JacksonHarvey1/FSAE2025/PIScreenshots/20260428_06h55m11s_grim.png

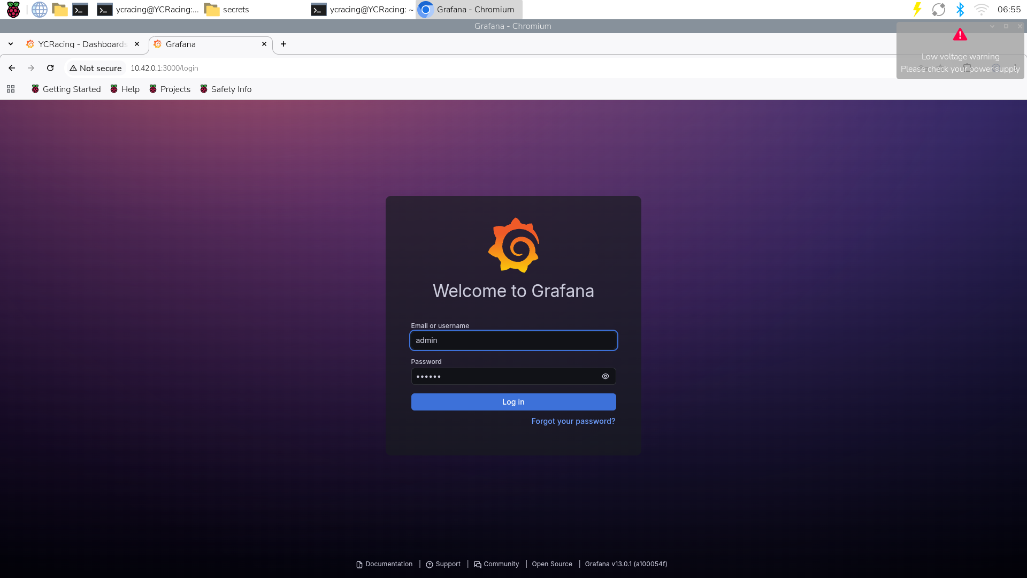
PIScreenshots/20260428_06h55m11s_grim.png
