JacksonHarvey1/FSAE2025/PIScreenshots/20260428_01h30m33s_grim.png

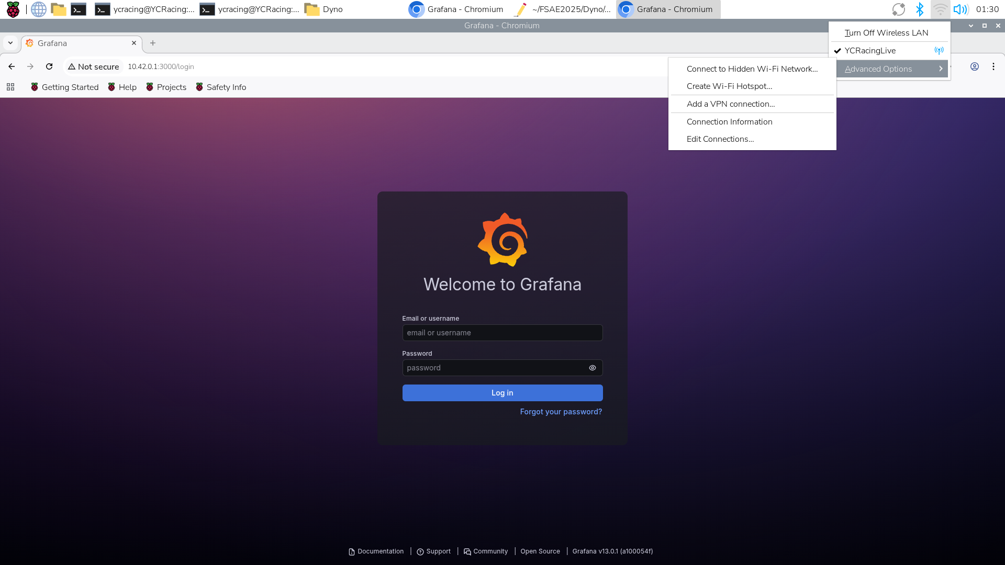
PIScreenshots/20260428_01h30m33s_grim.png
