JacksonHarvey1/FSAE2025/README.md

# YCP Formula SAE 2025 Telemetry System

Real-time data acquisition for the York College Formula SAE program. The car-side stack reads Bosch MS4.3 (PE3 8400) CAN frames, calculates gear, samples IMU/steering/fuel inputs, transmits the active LoRa packet stream over 915 MHz, mirrors the stream to a Raspberry Pi base station, and logs local SD plus InfluxDB/Grafana data for analysis.

---

## Quick Start (Car-Focused)
1. **Hardware** - Two Adafruit Feather RP2040 RFM boards (PID 5714), one on-car with MCP2515 CAN transceiver, LSM6DSOX IMU, MCP4725 DAC, and SPI SD breakout; the second Feather sits at the base station as the LoRa receiver. Terminate the car CAN bus at 500 kbps.
2. **Libraries** - Install the Earle Philhower `arduino-pico` cores plus **RadioHead (RH_RF95)**, **SdFat**, **Adafruit LSM6DS**, **Adafruit Unified Sensor**, and **Adafruit BusIO**. Local copies live under `libraries/`.
3. **On-car telemetry firmware** - Open `Car/CarCanLoRaTx/CarCanLoRaTx.ino`, confirm pin assignments/table below, set LoRa region (default 915 MHz @ 17 dBm), build, and flash. Keep the board still for the gyro bias routine at boot.
4. **Standalone dash firmware** - `Car/CarDash/CarDash.ino` is the dash-only CAN reader for gear DAC + warning LEDs when LoRa/SD/IMU logging is not needed.
5. **Base-station firmware** - Flash `Car/CarLoRaRxToPi/CarLoRaRxToPi.ino` onto the second Feather. Connect via USB to the Pi (or a laptop) at 115200 baud to watch NDJSON output.
6. **Pi ingest** - On the Raspberry Pi in the pit/dyno cart, run `Dyno/dyno_ingest_influx.py` for a lightweight logger or bring up the full Docker stack in `Dyno/stack/` (InfluxDB 2 + Grafana). Dash-only development can use `Dyno/Dyno_Final.py`.
7. **Verify** - Use the serial console: `[STATUS]` and `[GCALC]` lines from the TX/dash sketches, JSON from the RX sketch, and `test_json_serial.py` or `Dyno/dyno_simple.py` to sanity-check data before a run.

---

## Repository Map
```
FSAE2025/
|-- Car/
|   |-- CarCanLoRaTx/           # On-car CAN->LoRa transmitter (Feather RP2040 RFM)
|   |-- CarDash/                # Standalone dash: CAN gear DAC + warning LEDs
|   `-- CarLoRaRxToPi/          # Base-station LoRa receiver -> USB serial JSON
|-- Dyno/                       # Pi ingest scripts, Dash UI, Docker stack, docs
|   |-- DynoRP2040_MCP2515Wing/ # Optional dyno-only Feather CAN sketch
|   `-- stack/                  # compose.yaml + helper scripts (InfluxDB/Grafana)
|-- Testing/                    # Stand-alone CAN/LoRa/SD/IMU sketches + Python tools
|-- Data/                       # Logged CSVs, Excel analysis, post-processing scripts
|-- Reference Documents/        # Bosch DBC, datasheets, wiring diagrams
|-- libraries/                  # Vendored Arduino deps (Adafruit_* and RadioHead)
|-- Archive/                    # 2024 code + experiments (read-only history)
`-- README.md                   # You are here
```

---

## System Architecture
```
+----------------------------- CAR ----------------------------------+
| Bosch PE3 8400 ECU (500 kbps CAN)                                 |
|    |                                                              |
|  MCP2515 + Feather RP2040 RFM   LSM6DSOX   MCP4725   SD (SPI)      |
|    |             |                |         |         |            |
|    +-- CarCanLoRaTx.ino -- LoRa 915 MHz -----------------------+   |
+-------------------------------------------------------------------+
                             |
                             v
+------------------------- Base Station -----------------------------+
| Feather RP2040 RFM (CarLoRaRxToPi.ino) -> USB serial NDJSON        |
| Raspberry Pi                                                       |
|  - dyno_ingest_influx.py -> InfluxDB 2.x                           |
|  - Dyno/stack (docker compose) -> InfluxDB + Grafana               |
|  - Dyno_Final.py / dyno_simple.py (Dash/matplotlib live view)      |
+-------------------------------------------------------------------+
                             |
               Wi-Fi hotspot / Ethernet for driver, dyno, cloud
```

---

## Car Platform

### Hardware Stack
| Subsystem | Part | Notes |
|---|---|---|
| MCU + LoRa | Adafruit Feather RP2040 RFM (915 MHz RFM95) | Shared SPI bus for CAN/LoRa/SD |
| CAN | MCP2515 + TJA1050 (or similar) | 16 MHz crystal, configured for 500 kbps |
| IMU | Adafruit LSM6DSOX | I2C @ 0x6A, sampled at 100 Hz |
| Gear DAC | MCP4725 | I2C @ 0x60 (A0=GND). Output drives PE3 Analog #5 (0-5 V). |
| Storage | SPI microSD breakout | Uses SdFat in shared SPI mode; active TX logs at 50 Hz |
| Sensors (Dyno) | Optional Feather RP2040 CAN + LSM6DSOX | See `Dyno/DynoRP2040_MCP2515Wing` |

### Feather RP2040 RFM Pin Map (Car TX)
| Function | GPIO | Notes |
|---|---|---|
| SPI MISO | 8 | Shared CAN / LoRa / SD |
| SPI MOSI | 15 | Shared |
| SPI SCK | 14 | Shared |
| MCP2515 CS | 5 | Adafruit CAN FeatherWing default CS |
| RFM95 CS / INT / RST | 16 / 21 / 17 | RFM95 is on-board; RST toggled at boot |
| SD CS | 25 | Initialize SD *before* the radio |
| I2C SDA / SCL | 2 / 3 | IMU (0x6A) + DAC (0x60) |
| Steering angle ADC | A0 (GP26) | 0-5 V pot -> voltage divider -> 0-3.3 V |
| Fuel level sensor | A1 (GP27) | Telemetry TX uses 10 kOhm pull-up + PANW 103395-395 NTC; dash sketch uses voltage threshold only |
| Neutral switch input | 12 | `INPUT_PULLUP`; LOW = neutral |
| Engine warning LED | 11 | SK6812 NeoPixel; red if CLT > 200 F |
| Oil pressure warning LED | 7 | SK6812 NeoPixel in `CarCanLoRaTx`; red if oil < 30 psi |
| Shift indicator LED | 9 | SK6812 NeoPixel; blue if RPM >= 13,000 |
| Low fuel warning LED | 10 | SK6812 NeoPixel; amber after A1 stays below threshold for 15 s |
| Neutral light LED | 6 | SK6812 NeoPixel; green when neutral switch is LOW or calculated gear is neutral |
| On-board LED | LED_BUILTIN | Heartbeat / status blink |

---

### `Car/CarCanLoRaTx/CarCanLoRaTx.ino`
* **CAN ingest** - Custom MCP2515 driver configures CNF1/2/3 for 500 kbps @ 16 MHz. Frames `0x770` / `0x771` / `0x772` / `0x790` are decoded to engineering units — see [Transmitted Data](#transmitted-data) below for the full field list.
* **IMU pipeline** - LSM6DSOX is initialized at 104 Hz, gyro bias is averaged for one second on boot, and 100 Hz samples are converted to g and deg/s for local SD logging.
* **Gear detection + DAC** - `GEAR_BANDS` holds RPM/kph ratio bands with hysteresis and sample confirmation (4 consecutive matches) to avoid flapping. `MCP4725` outputs the midpoint voltages: Neutral 0.305 V, 1st 1.00 V, 2nd 1.70 V, 3rd 2.50 V, 4th 3.305 V, 5th 4.095 V. The DAC is forced to Neutral at boot so PE3 always sees a safe voltage.
* **LoRa link** - RFM95 sends binary packets over 915 MHz @ 17 dBm (all little-endian). The lower transmit power avoids 3.3 V rail droop during radio bursts.

  | Type | Size | Header | Payload |
  |------|------|--------|---------|
  | `0x01` CAN frame | 24 B | `[0xA5][0x01][flags][dlc]` | `[id:4][ts_ms:4][data:8][seq:4]` |
  | `0x02` IMU | 22 B | `[0xA5][0x02][seq:4][ts_ms:4]` | `[ax/ay/az x 0.001 g : 3 x int16][gx/gy/gz x 0.1 deg/s : 3 x int16]`; supported by the RX/test harness, not currently emitted by `CarCanLoRaTx` |
  | `0x03` Analog | 12 B | `[0xA5][0x03][seq:4][ts_ms:4]` | `[steer x 0.1 deg : int16]` |

* **SD logging** - `LOG_####.CSV` files capture the following columns at 50 Hz using an 8 KB RAM buffer that flushes every second. SdFat runs in `SHARED_SPI` mode so the SD must be initialized before the radio.
  `ts_s, rpm, gear, ax_g, ay_g, az_g, gx_dps, gy_dps, gz_dps, steer_deg`
* **Serial diagnostics** - The sketch prints `[STATUS]`, `[GCALC]`, decoded CAN values, and IMU details. If MCP2515 reports `EFLG != 0`, the flag byte is shown for quick wiring debug.
* **Build settings** - Board: `Adafruit Feather RP2040` (Earle Philhower core). Use 125 MHz CPU, 16 MB flash (2 MB sketch). Required libraries live in `libraries/` if you prefer `arduino-cli --libraries`. LoRa frequency/power are at the top of the file.

**Modifying CAN channels:** Add decode logic inside `updateTxSnapshot` and `printDecoded`, then extend the JSON emitters on the RX side (see below) or the SD logger header to capture new fields. Use `Reference Documents/70000003 PE3 Bosch MS4.3 CAN Bus v01.dbc` to map IDs.

---

### `Car/CarDash/CarDash.ino`
* **Purpose** - Lightweight dash firmware for the Feather RP2040 + CAN FeatherWing when the car only needs local gear DAC and warning indicators. It does not initialize LoRa, SD, or the IMU.
* **CAN inputs** - Reads Bosch `0x770` and `0x790` at 500 kbps for RPM, vehicle speed, and coolant temperature. Stale RPM/speed values are zeroed after a 500 ms CAN timeout.
* **Outputs** - Drives the MCP4725 gear voltage table used by the PE3 Analog #5 input and the SK6812 warning LEDs. The neutral light uses a dedicated switch on GPIO 12 (`INPUT_PULLUP`, LOW = neutral).
* **Dash thresholds** - Engine warning at CLT > 200 F, shift light at RPM >= 13,000, low fuel after A1 stays below 1.2 V for 15 s. Serial status prints every 5 s.

---

### `Car/CarLoRaRxToPi/CarLoRaRxToPi.ino`
* **Purpose** - Listens for the binary LoRa frames above, reconstructs the Bosch snapshot, and streams newline-delimited JSON (NDJSON) at 10 Hz over USB (115200 baud). IMU packets are supported and emitted immediately with `"t":"imu"` if a transmitter sends packet `0x02`.
* **JSON fields (Bosch line)** - `pkt,rpm,veh_kph,tps_pct,map_kpa,map_ext_kpa,batt_v,coolant_f,air_f,oil_temp_f,ign_deg,lambda1,lambda2,fuel_psi,oil_psi,inj_ms,gear,rssi`.
* **IMU JSON** - `{"t":"imu","pkt":<seq>,"ax_g":...,"gx_dps":...,"rssi":...}` for packet `0x02`.
* **Heartbeat** - Lines starting with `#` provide uptime, packet counts, and last RSSI for shell scripts to monitor.
* **Integration points** - `Dyno/dyno_ingest_influx.py`, `Dyno/dyno_simple.py`, and `Testing/test_json_serial.py` all expect this NDJSON stream.

---

## Transmitted Data

Active car LoRa traffic uses `0xA5` packet types. `CarCanLoRaTx` currently emits raw CAN frames (`0x01`) and steering analog (`0x03`); `CarLoRaRxToPi` also supports IMU packet `0x02` for test transmitters or future TX firmware.

### Packet 0x01 — Bosch MS4.3 CAN Frames

Raw CAN frames from the four decoded IDs. The receiver reconstructs the snapshot from the row-muxed payloads.

| CAN ID | Row / Condition | Field | Source formula | Units |
|---|---|---|---|---|
| 0x770 | any | **RPM** | `u16(d[1],d[2]) × 0.25` | rpm |
| 0x770 | any | **Vehicle speed** | `u16(d[3],d[4]) × 0.00781` | km/h |
| 0x770 | any | **Throttle position (TPS)** | `d[5] × 0.391` | % |
| 0x770 | any | **Ignition advance** | `(int8)d[6] × 1.365` | °BTDC |
| 0x770 | row 3 | **Coolant temp (CLT)** | `d[7] − 40` | °C |
| 0x770 | row 4 | **Oil temp 1 (ECU)** | `d[7] − 39` | °C |
| 0x770 | row 6 | **Intake air temp (IAT)** | `d[7] − 40` | °C |
| 0x770 | row 9 | **Gear (ECU)** | `d[7]` | 0–5 |
| 0x771 | row 0 | **MAP** | `u16(d[5],d[6]) × 0.01` | kPa |
| 0x771 | row 1 | **Battery voltage** | `d[7] × 0.111` | V |
| 0x771 | row 3 | **Fuel pressure** | `d[5] × 0.0515 × 14.504` | psi |
| 0x771 | row 3 | **Oil pressure** | `d[7] × 0.0513 × 14.504` | psi |
| 0x772 | row 0 | **Lambda 1** | `u16(d[2],d[3]) × 0.000244` | λ |
| 0x772 | row 0 | **Lambda 2** | `u16(d[4],d[5]) × 0.000244` | λ |
| 0x772 | row 3 | **Injector pulse width** | `d[2] × 0.8192` | ms |
| 0x790 | — | **RPM (hi-res)** | `u16(d[0],d[1])` | rpm |
| 0x790 | — | **Ignition (hi-res)** | `u16(d[4],d[5]) × 0.1` | °BTDC |
| 0x790 | — | **MAP (ext)** | `u16(d[6],d[7]) × 0.01 × 6.895` | kPa |

### Packet 0x02 — IMU (LSM6DSOX, 100 Hz)

| Field | Scaling | Units |
|---|---|---|
| **Accel X (ax)** | int16 × 0.001 | g |
| **Accel Y (ay)** | int16 × 0.001 | g |
| **Accel Z (az)** | int16 × 0.001 | g |
| **Gyro X (gx)** | int16 × 0.1 | °/s |
| **Gyro Y (gy)** | int16 × 0.1 | °/s |
| **Gyro Z (gz)** | int16 × 0.1 | °/s |

Gyro bias is averaged over 1 second at boot and subtracted from every local SD sample. Packet `0x02` is decoded by the receiver but is not currently sent by the active `CarCanLoRaTx` sketch.

### Packet 0x03 — Analog Sensors (2 Hz)

| Field | Pin | Scaling | Units |
|---|-----|---|---|
| **Steering angle** | A0 / GP26 | int16 × 0.1 | ° (neg = left) |

### Calculated / Derived Fields (on-car, also logged to SD)

| Field | Derivation |
|---|---|
| **Gear (calculated)** | RPM ÷ km/h ratio matched against `GEAR_BANDS[5]` with 4-sample hysteresis |
| **Fuel level** | A1 / GP27 voltage threshold. `CarCanLoRaTx`: `FUEL_LOW_THRESH_V = 1.52 V`; `CarDash`: `FUEL_LOW_THRESH_V = 1.2 V`. Both require 15 s continuously below threshold. |
| **Gear DAC output** | `MCP4725` drives PE3 Analog #5: N=0.305 V, 1st=1.00 V, 2nd=1.70 V, 3rd=2.50 V, 4th=3.305 V, 5th=4.095 V |

### InfluxDB Schema

The ingest script (`Dyno/dyno_ingest_influx.py`) writes all fields to a single measurement.

| Parameter | Value |
|---|---|
| **Measurement** | `telemetry` |
| **Tag: system** | `dyno` |
| **Tag: node** | `rp2040` |
| **Organisation** | `yorkracing` |
| **Bucket** | `telemetry` |

| InfluxDB Field | Source | Units |
|---|---|---|
| `rpm` | 0x770 / 0x790 | rpm |
| `veh_kph` | 0x770 | km/h |
| `tps_pct` | 0x770 | % |
| `ign_deg` | 0x770 / 0x790 | °BTDC |
| `map_kpa` | 0x771 row 0 | kPa |
| `map_ext_kpa` | 0x790 | kPa |
| `lambda1` | 0x772 row 0 | λ |
| `lambda2` | 0x772 row 0 | λ |
| `batt_v` | 0x771 row 1 | V |
| `coolant_f` | 0x770 row 3 | °F |
| `oil_temp_f` | 0x770 row 4 | °F |
| `air_f` | 0x770 row 6 | °F |
| `gear` | 0x770 row 9 | 0–5 |
| `fuel_psi` | 0x771 row 3 | psi |
| `oil_psi` | 0x771 row 3 | psi |
| `inj_ms` | 0x772 row 3 | ms |
| `ax_g` | IMU packet 0x02 | g |
| `ay_g` | IMU packet 0x02 | g |
| `az_g` | IMU packet 0x02 | g |
| `gx_dps` | IMU packet 0x02 | °/s |
| `gy_dps` | IMU packet 0x02 | °/s |
| `gz_dps` | IMU packet 0x02 | °/s |
| `rssi` | LoRa link quality | dBm |

Example Flux query for Grafana:
```flux
from(bucket: "telemetry")
  |> range(start: -5m)
  |> filter(fn: (r) => r._measurement == "telemetry")
  |> filter(fn: (r) => r._field == "rpm" or r._field == "tps_pct")
```

---

### Warning Indicators (on-car LEDs only, not transmitted)

| LED | Trigger |
|-----|---|
| Engine warning (red) | CLT > 200 °F |
| Oil pressure warning (red) | `CarCanLoRaTx` only: oil < 30 psi |
| Low fuel (amber) | A1 below threshold for 15 s |
| Shift indicator (blue) | RPM >= 13,000 |
| Neutral light (green) | Neutral switch LOW in `CarDash`; calculated gear == 0 in `CarCanLoRaTx` |

---

## Raspberry Pi + Cloud Stack (`Dyno/`)
* **Live ingest script** - `Dyno/dyno_ingest_influx.py` auto-detects the Feather serial port, filters non-JSON lines, de-dupes packets, and writes measurements to InfluxDB 2.x using the `influxdb-client` Python SDK. Environment overrides: `TELEM_PORT`, `TELEM_BAUD`, `INFLUX_URL`, `INFLUX_ORG`, `INFLUX_BUCKET`, `INFLUX_TOKEN` or `INFLUX_TOKEN_FILE`.
* **Full Pi setup guide** - `Dyno/PI_SETUP.md` covers everything end-to-end: WiFi hotspot, Docker stack autostart, and ingest autostart on a fresh Pi. Start here for any new hardware.
* **Docker services** - `Dyno/stack/compose.yaml` launches InfluxDB 2 + Grafana with persistent volumes. Copy the example secrets in `Dyno/stack/secrets/`, edit passwords/tokens, then `docker compose up -d`. Helper scripts (`setup_grafana.sh`, `fix_influxdb.sh`, etc.) automate first-boot tasks.
* **Dash UI** - `Dyno/Dyno_Final.py` is a Plotly Dash app for laptops or the Pi. It auto-detects the serial port, streams packets, and exposes UI controls for key selection, time window, and theming. `Dyno/dyno_simple.py` is a lighter matplotlib live plot.
* **Services & Wi-Fi** - `Dyno/dyno-ingest.service` and `Dyno/start_ingest.sh` provide systemd units for auto-start, while `Dyno/WIFI_HOTSPOT_SETUP.md` documents the dedicated `YorkRacing` hotspot used at the track/dyno.

---

## Dyno Bench Node
`Dyno/DynoRP2040_MCP2515Wing/DynoRP2040_MCP2515Wing.ino` targets a Feather RP2040 plus the Adafruit CAN FeatherWing. It mirrors the Bosch decode logic but sends JSON directly over USB at 20 Hz (921600 baud) and can optionally include IMU data. Use this when the car is not available but you still need CAN data on the dyno.

`Dyno/DynoRP204CANHATIntegration/` holds an earlier variant that pairs the Feather with a Raspberry Pi CAN hat; keep it for reference or regression tests.

---

## Testing & Diagnostics (`Testing/`)
* **CAN + LoRa harness** - `Testing/TransmitterCANTest/` and `Testing/ReciverCANTest/` form a loopback pair documented in `Testing/CANTest_README.md`. `TransmitterCANTest` generates synthetic waveforms for `0x01` CAN frames, `0x02` IMU, and the older 14-byte `0x03` analog packet that includes steering plus oil temp 2; the active car TX now sends the 12-byte steering-only `0x03` packet.
* **Focused sketches** - `BoschDecodeTest`, `SDCardTest`, `AccelerometerAndGyro`, `SimpleCANTest`, `TransmitterTest`, etc., isolate each subsystem for bench validation.
* **Python utilities** - `simple_serial_test.py`, `test_json_serial.py`, and `pyserialAccelerometerLogging.py` consume NDJSON or raw serial streams for quick plots and logging on a laptop.
* **Recommended workflow** - Run the CAN/LoRa pair first, then `SDCardTest` with the actual SD breakout, finish with the full `CarCanLoRaTx` sketch on a bench harness before installing on the vehicle.

---

## Data & Post-Processing (`Data/`)
* `Data/2025 Car/Car Runs/` - CSV + Excel workbooks from recent runs (`10_18_runX_001.*`). Use them as templates for new SD logs.
* `Data/Dyno Runs/` - Protected directory for dyno pulls captured through the Pi stack.
* Utility scripts (`postproccess.py`, `check_map_columns.py`, `debug_columns.py`) normalize CSV columns and validate field names before import into Grafana or analysis notebooks.

---

## Reference Documents
Key resources for calibration, wiring, and CAN math:
* `Reference Documents/70000003 PE3 Bosch MS4.3 CAN Bus v01.dbc` - Official Bosch signal map used by both the transmitter and receiver sketches.
* Datasheets for every breakout (Feather RP2040 RFM, MCP4725, LSM6DSOX, MicroSD breakouts, CAN protocol notes) plus historical FSAE electrical documentation for 2023-2025 seasons.

---

## Libraries & Third-Party Assets
* `libraries/Adafruit_BusIO`, `Adafruit_CAN`, `Adafruit_MCP2515`, `RadioHead-master`, etc., mirror the versions tested with this repo. Point the Arduino IDE/CLI to this folder or install matching releases via the Library Manager.
* `RadioHead-master.zip` at the repo root is the original upstream archive; extract or remove after verifying the vendored copy.
* Python dependencies: `pyserial`, `influxdb-client`, `dash`, `dash-bootstrap-components`, `plotly`. Use a venv on the Pi/laptop to keep them isolated.

---

## Archive
`Archive/2024` and `Archive/2025` store past experiments (single-packet LoRa tests, dashboard prototypes, Raspberry Pi scripts, etc.). Treat them as read-only examples; all active firmware now lives under `Car/` and `Dyno/`.

---

## Extending the System
1. **Add a CAN channel** - Update the decode logic in both `CarCanLoRaTx` (for SD/gear calculations) and `CarLoRaRxToPi` (for JSON output). Reference the DBC for scaling, then update Grafana/Dash configs.
2. **Change LoRa behavior** - Adjust `LORA_FREQ_MHZ` and `LORA_TX_POWER_DBM` constants in both sketches. Keep the packet headers the same so existing ingest tools keep working.
3. **Tune gear detection** - Modify `GEAR_BANDS` and `GEAR_CONFIRM` after reviewing `[GCALC]` logs from real laps. The DAC table can also be tweaked if the PE3 calibration targets move.
4. **Stream to new backends** - Reuse `Dyno/dyno_ingest_influx.py` as a template (it already exposes JSON parsing utilities) if you need to forward data to MQTT, ROS, or cloud APIs.

With this README, new team members can follow the breadcrumb trail from hardware selection through firmware, ingestion, dashboards, and testing-especially on the car side where the CAN, IMU, SD, gear DAC, and LoRa stacks all converge. Happy tuning!
