JacksonHarvey1/FSAE2025/PIScreenshots/20260427_22h56m39s_grim.png

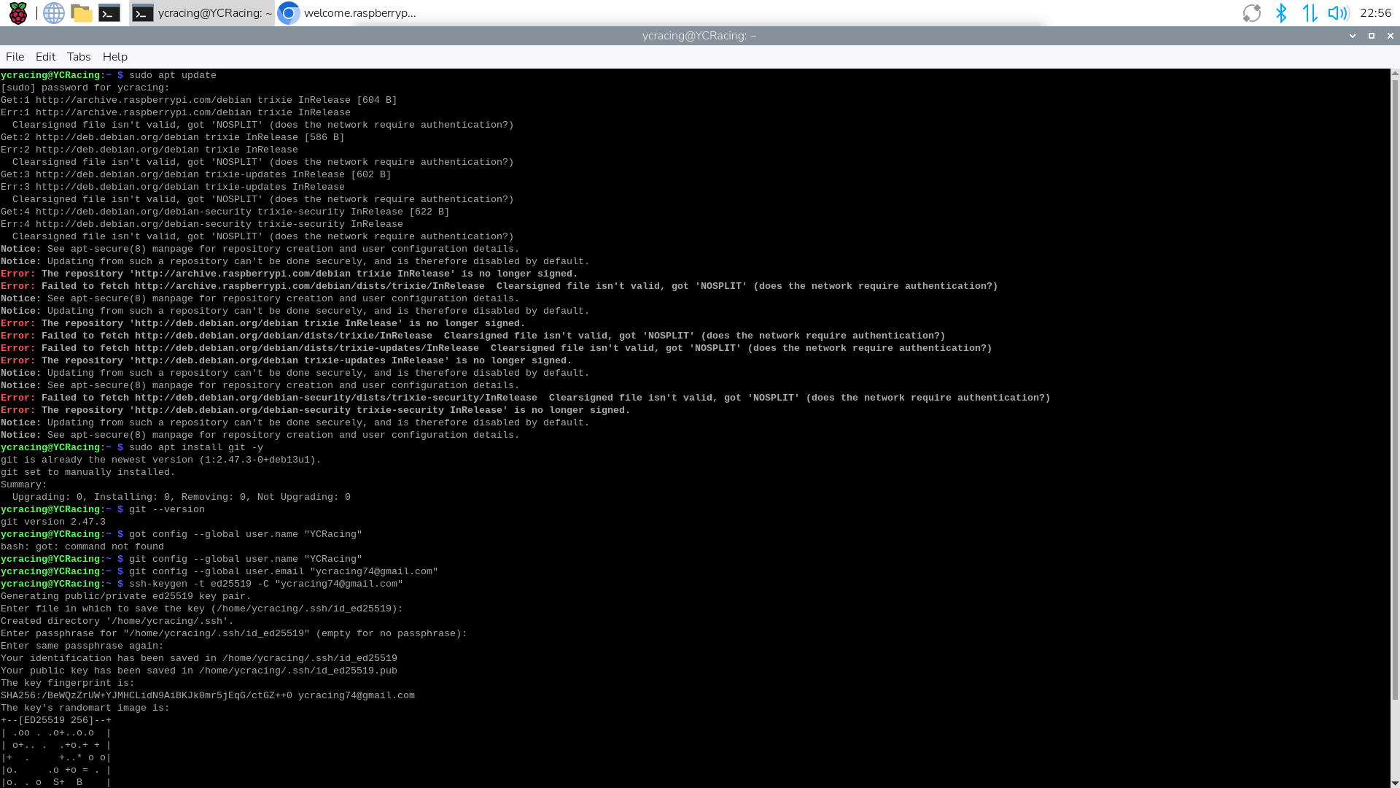
PIScreenshots/20260427_22h56m39s_grim.png
