JacksonHarvey1/FSAE2025/PIScreenshots/20260427_23h25m05s_grim.png

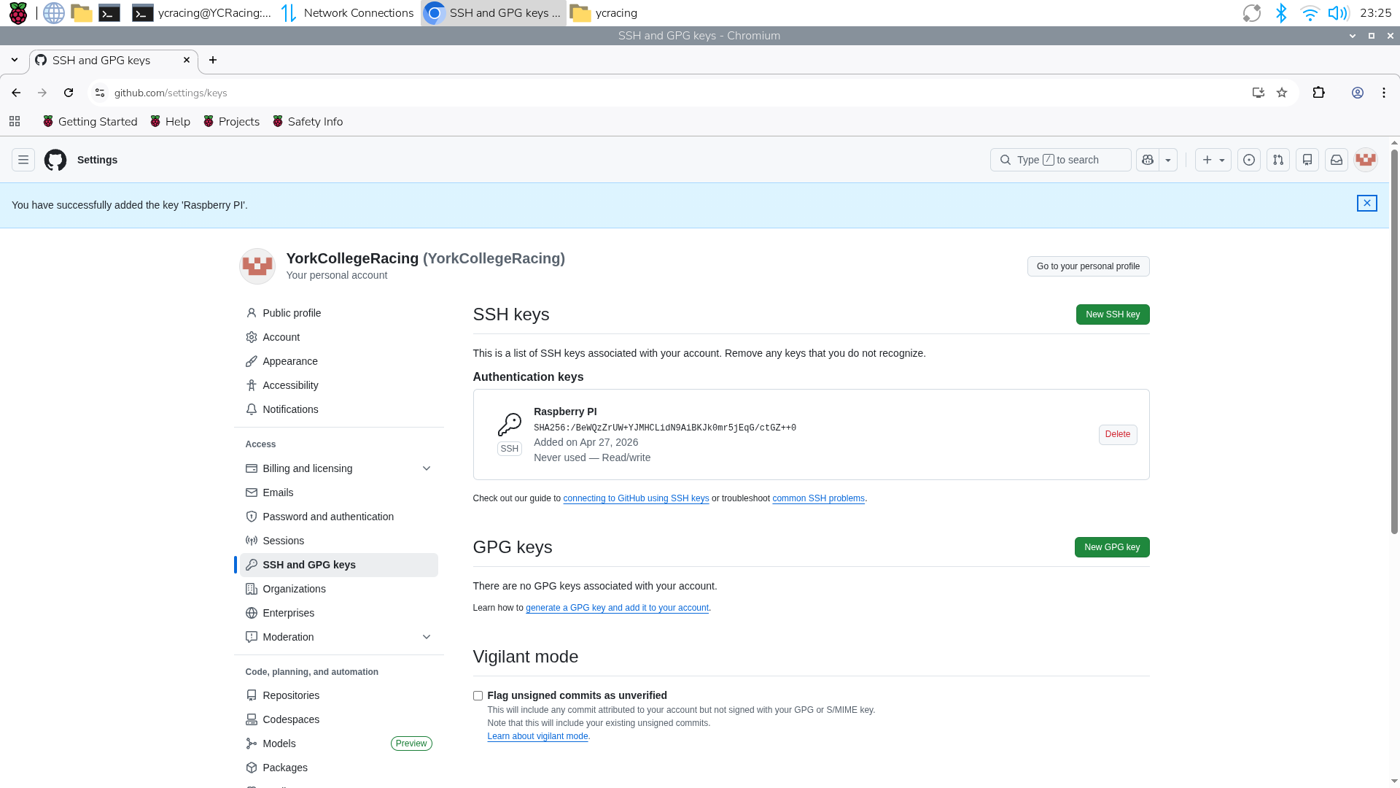
PIScreenshots/20260427_23h25m05s_grim.png
