JacksonHarvey1/FSAE2025/PIScreenshots/20260427_23h31m36s_grim.png

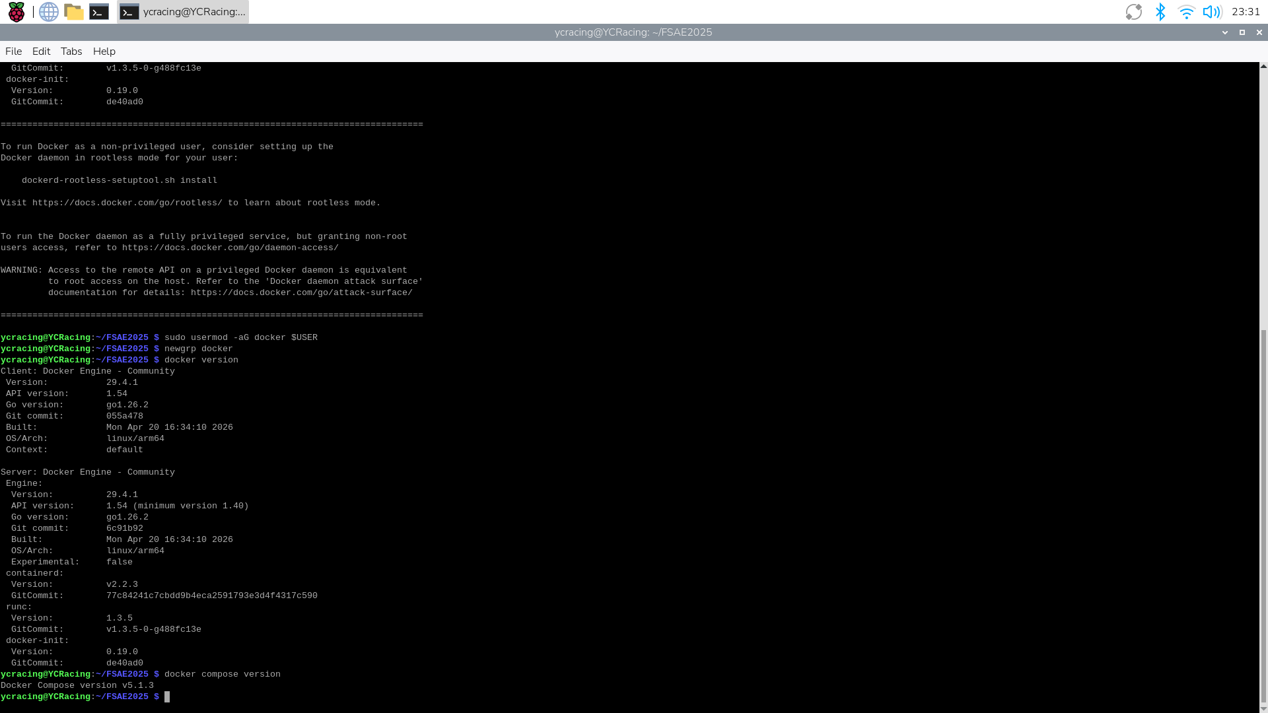
PIScreenshots/20260427_23h31m36s_grim.png
