JacksonHarvey1/FSAE2025/PIScreenshots/20260428_01h23m13s_grim.png

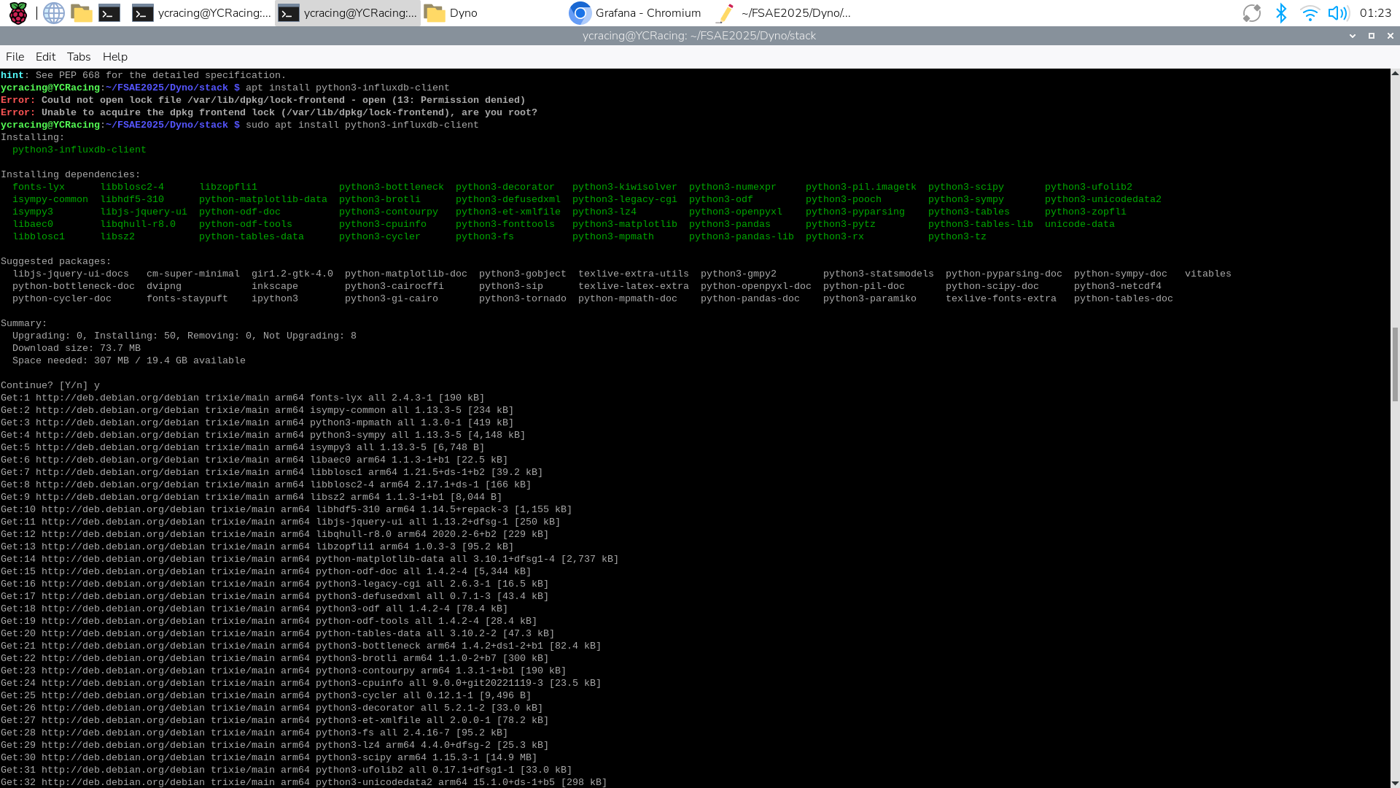
PIScreenshots/20260428_01h23m13s_grim.png
