JacksonHarvey1/FSAE2025/PIScreenshots/20260428_02h02m52s_grim.png

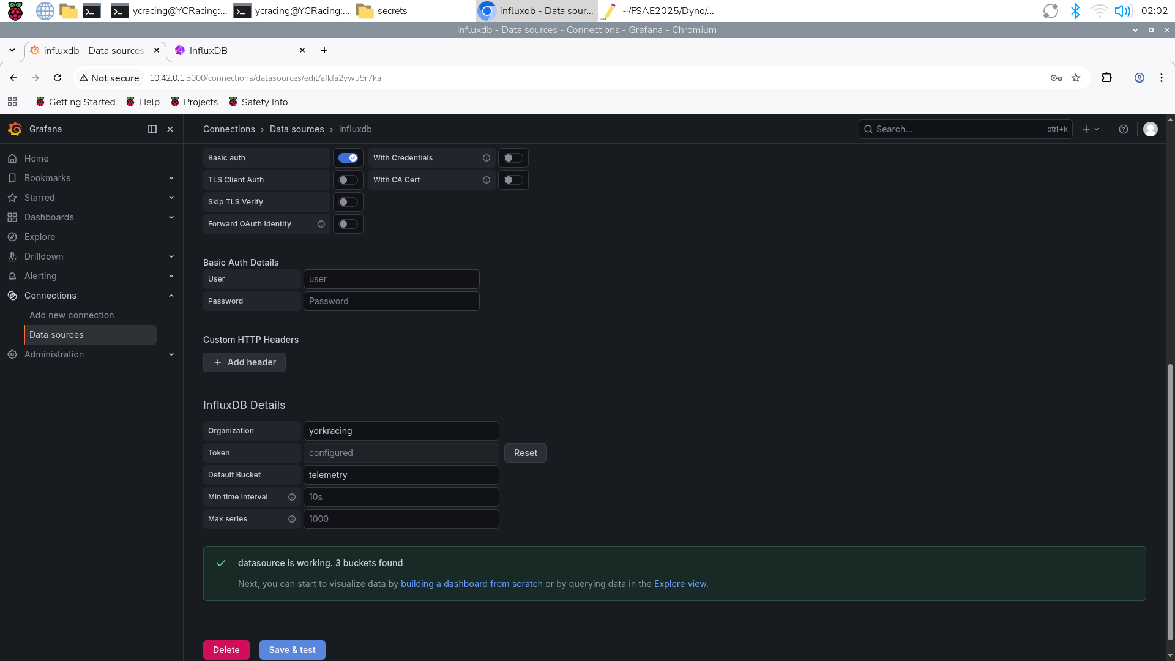
PIScreenshots/20260428_02h02m52s_grim.png
