JacksonHarvey1/FSAE2025/PIScreenshots/20260428_06h51m31s_grim.png

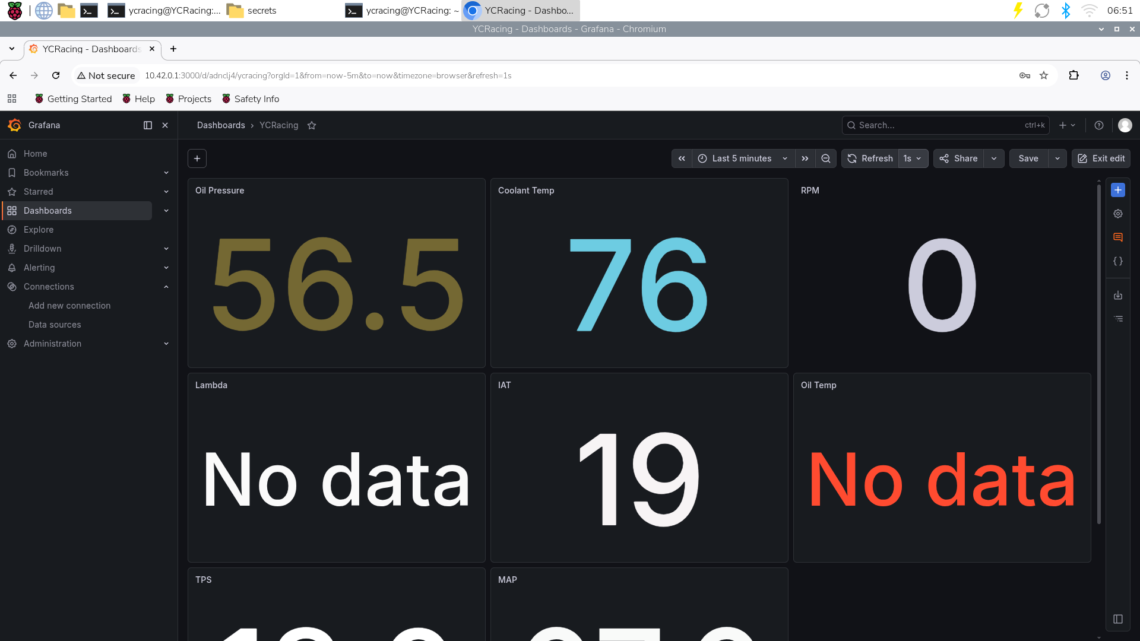
PIScreenshots/20260428_06h51m31s_grim.png
