JacksonHarvey1/FSAE2025/Reference Documents/89ab9bca-f0d2-4932-aa1b-d7cf8059c8b4.png

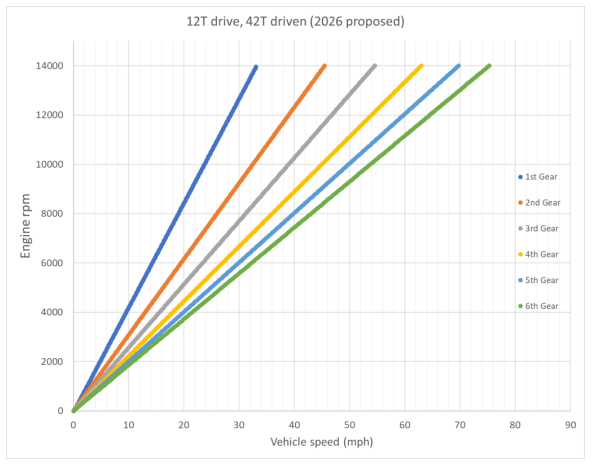
Reference Documents/89ab9bca-f0d2-4932-aa1b-d7cf8059c8b4.png
