JacksonHarvey1/FSAE2025/Reference Documents/20260406_10h39m45s_grim.png

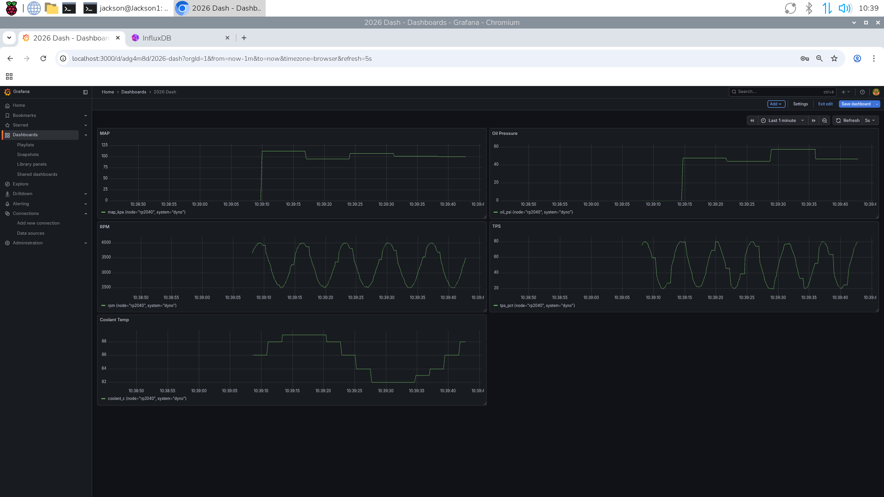
Reference Documents/20260406_10h39m45s_grim.png
