JacksonHarvey1/FSAE2025/Archive/2024/Packet_Layout_SQLite_Sensor_Pinout V.1.xlsx

Sheet: LoRa Packet
CAN ID | Name | Poisition in CAN Packet | Position in Lora Packet | Type | Resolution per Bit | Range | Position in Raspi code
0CFFF048 | RPM | 0-1 | 0-1 | Unsigned Int | 1 | 0 -30000 | 4-5
 | TPS | 2-3 | 2-3 | Signed Int | 0.1 | 0 -100 | 6-7
 | Fuel Open Time | 4-5 | REMOVED | Signed Int | 0.1 | 0-30 | REMOVED
 | Ignition Angle | 6-7 | REMOVED | Signed Int | 0.1 | -20-100 | REMOVED
0CFFF148 | Barometer | 0-1 | REMOVED | Signed Int | 0.01 | 0-300 | REMOVED
 | MAP | 2-3 | 8-9 | Signed Int | 0.01 | 0-300 | 8-9
 | Lambda | 4-5 | REMOVED | Signed Int | 0.01 | 0-10 | REMOVED
 | Pressure Type | 6-7 | REMOVED | Int | N/A | 0 - psi, 1 -kPa | REMOVED
0CFFF248 | Analog 1 | 0-1 | REMOVED | Signed Int | 0.001 | 0-5 | REMOVED
 | Analog 2 | 2-3 | 12-13 | Signed Int | 0.001 | 0-5 | 10-11
 | Analog 3 | 4-5 | 14-15 | Signed Int | 0.001 | 0-5 | 12-13
 | Analog 4 | 6-7 | 16-17 | Signed Int | 0.001 | 0-5 | 14-15
0CFFF348 | Analog 5 | 0-1 | 18-19 | Signed Int | 0.001 | 0-5 | 16-17
 | Analog 6 | 2-3 | 20-21 | Signed Int | 0.001 | 0-5 | 18-19
 | Analog 7 | 4-5 | 22-23 | Signed Int | 0.001 | 0-5 | 20-21
 | Analog 8 | 6-7 | REMOVED | Signed Int | 0.001 | 0-5 | REMOVED
0CFFF448 | Freq 1 | 0-1 | 24-25 | Signed Int | 0.2 | 0-6000 | 22-23
 | Freq 2 | 2-3 | 26-27 | Signed Int | 0.2 | 0-6000 | 24-25
 | Freq 3 | 4-5 | 28-29 | Signed Int | 0.2 | 0-6000 | 26-27
 | Freq 4 | 6-7 | 30-31 | Signed Int | 0.2 | 0-6000 | 28-29
0CFFF548 | Battery Voltage | 0-1 | 32-33 | Signed Int | 0.01 | 0-22 | 30-31
 | Air Temp | 2-3 | 34-35 | Signed Int | 0.1 | -1000-1000 | 32-33
 | Coolant Temp | 4-5 | 36-37 | Signed Int | 0.1 | -1000-1000 | 34-35
 | Temp Type | 6-7 | REMOVED | Int | N/A | 0 - F, 1 - C | REMOVED
ADXL345 | Acceleromter X | N/A | 38-39 | Signed Int | 0.01 | -16 - 16 | 36-37
 | Acceleromter Y | N/A | 40-41 | Signed Int | 0.01 | -16 - 16 | 38-39
 | Acceleromter Z | N/A | 42-43 | Signed Int | 0.01 | -16 - 16 | 40-41
 |  |  |  |  |  | 0000000000

Sheet: Pinouts
ECU Sensor Pinout
Pin Name | Pin# | Sensor
Analog 1 | C-05 | Oxygen
Analog 2 | C-06 | Oil Pressure
Analog 3 | C-18 | Shock FR
Analog 4 | C-19 | Shock FL
Analog 5 | M-08 | Shock BR
Analog 6 | M-23 | Shock BL
Analog 7 | M-31 | Steering Angle
Analog 8 | M-15
Digital 1 | M-14 | WH SP FR
Digital 2 | M-13 | WH SP FL
Digital 3 | C-16 | WH SP BR
Digital 4 | C-03 | WH SP BL
RP 2040 Pinouts
Pin Name | Functional | Device
STEMMA | SPI | Accelerometer
USB | 5V in | RP2040
GND | --- | ---
GPIO 13 | Set to GND | LoRa On/off
GPIO 12 | Connected to 13 | LoRa On/off
GPIO 6 | SDA | Neopixel Stick
GPIO 24 | SDA | Neopixels
CAN L | CAN Comms | to ECU C-07
CAN GND | --- | ---
CAN H | CAN Comms | to ECU C-08
uFL | LoRa Comms | LoRa Antenna
Chained Neopixels GPIO 24
Neopixels | Number
Battery Voltage | 0
Coolant Temp | 1
Oil Pressure | 2
Neutral Light | 3
 |  |  | Does not include level logic shifter

Sheet: SQLite Table Layout
Name | SQLite Column Name | Data Type
RPM | RPM | Integer
TPS | TPS | Real
MAP | MAP | Real
Oil Pressure / Analog 2 | Oil_Pressure | Real
Shock Pot FR / Analog 3 | Shock_Pot_FR | Real
Shock Pot FL / Analog 4 | Shock_Pot_FL | Real
Shock Pot BR / Analog 5 | Shock_Pot_BR | Real
Shock Pot BL / Analog 6 | Shock_Pot_BL | Real
Steering angle / Analog 7 | Steering_Angle | Real
Wheel Speed FR / Freq 1 | Wheel_Speed_FR | Real
Wheel Speed FL / Freq 2 | Wheel_Speed_FL | Real
Wheel Speed BR / Freq 3 | Wheel_Speed_BR | Real
Wheel Speed BL / Freq 4 | Wheel_Speed_BL | Real
Battery Voltage | Battery_Voltage | Real
Air Temp | Air_Temp | Real
Coolant Temp | Coolant_Temp | Real
Acceleromter X | Accelerometer_X | Real
Acceleromter Y | Accelerometer_Y | Real
Acceleromter Z | Accelerometer_Z | Real
Timestamp | Timestamp | Timestamp
