JacksonHarvey1/FSAE2025/Data/Dyno Runs/12-17-2025 Dyno Test 2 Black Restrictor_001.csv

Time (sec) | RPM | Air Temp (F) | Coolant Temp (F) | TPS (%) | TPS Rate (%/sec) | MAP (kPa) | Battery Volt (V) | Fuel Open Time (ms) | Accel Compensation - Fuel (%) | Starting Compensation - Fuel (%) | Air Temp Compensation - Fuel (%) | Coolant Temp Compensation - Fuel (%) | Barometer Compensation - Fuel (%) | Map Compensation - Fuel (%) | Ignition Angle (DBTDC) | Coolant Temp Compensation - Ignition (deg) | Injector Over Current #1 | Injector Over Current #2 | Injector Over Current #3 | Injector Over Current #4 | Injector Over Current #5 | Injector Over Current #6 | Injector Over Current #7 | Injector Over Current #8 | Coil Over Current #1 | Coil Over Current #2 | Coil Over Current #3 | Coil Over Current #4 | Coil Over Current #5 | Coil Over Current #6 | Coil Over Current #7 | Coil Over Current #8 | System Temperature (F) | Sensor Error | Open Time Clip | Charge Time Clip | Measured Lambda #1 | Target Lambda | Lambda/AFR Status | Lambda/AFR STF #1 (%) | Accel Base Comp (%) | Crank Error Count | Power On Count
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
