JacksonHarvey1/FSAE2025/Dyno/dyno_ingest_influx.py

#!/usr/bin/env python3
"""Dyno telemetry ingest: RP2040 serial NDJSON -> InfluxDB 2.x

This is a drop-in companion to `Dyno/dyno_simple.py`.

Behavior preserved from dyno_simple.py:
- Reads newline-delimited JSON from a serial port (ser.read_until(b"\n"))
- Skips DBG/# lines and non-JSON lines
- De-dupes packets using obj["pkt"] if present
- Re-opens the serial port on errors

Influx behavior:
- Writes to InfluxDB 2.x using influxdb-client
- Measurement defaults to "telemetry"
- Tags default to: system=dyno, node=rp2040
- Writes a fixed set of numeric fields by default: rpm,tps_pct,map_kpa,batt_v,coolant_c

Typical usage on the Pi (token from file):
  python3 -m pip install --upgrade pyserial influxdb-client
  export INFLUX_TOKEN_FILE="$HOME/dyno_stack/secrets/influxdb2-admin-token"
  python3 Dyno/dyno_ingest_influx.py
"""

from __future__ import annotations

import glob
import json
import os
import time
from typing import Any, Dict, Optional

import serial
from influxdb_client import InfluxDBClient, Point
from influxdb_client.client.write_api import SYNCHRONOUS


# ---- SERIAL CONFIG (auto-detects RP2040 port) ----
def find_serial_port():
    """Auto-detect the RP2040 serial port"""
    patterns = [
        "/dev/serial/by-id/usb-Adafruit_Feather_RP2040_CAN_*",
        "/dev/serial/by-id/usb-Adafruit_Feather_RP2040_*",
        "/dev/ttyACM*",
    ]
    
    for pattern in patterns:
        matches = sorted(glob.glob(pattern))
        if matches:
            return matches[0]
    return "/dev/ttyACM0"  # fallback

PORT = os.getenv("TELEM_PORT") or find_serial_port()
BAUD = int(os.getenv("TELEM_BAUD", "115200"))  # CarLoRaRxToPi baud rate


# ---- INFLUX CONFIG ----
# Hardcoded defaults to avoid encoding issues
INFLUX_URL = os.getenv("INFLUX_URL") or "http://localhost:8086"
INFLUX_ORG = os.getenv("INFLUX_ORG") or "yorkracing"
INFLUX_BUCKET = os.getenv("INFLUX_BUCKET") or "telemetry"

# Auto-find token file if not specified
def find_token_file():
    """Try to find the InfluxDB token file automatically"""
    # Check common locations
    possible_paths = [
        os.path.join(os.path.expanduser("~"), "FSAE2025/Dyno/stack/secrets/influxdb2-admin-token"),
        os.path.join(os.path.dirname(__file__), "stack/secrets/influxdb2-admin-token"),
        "./stack/secrets/influxdb2-admin-token",
    ]
    
    for path in possible_paths:
        if os.path.exists(path):
            return path
    return None

# Prefer token from file (safer than putting it in shell history)
INFLUX_TOKEN = os.getenv("INFLUX_TOKEN", "").strip()
INFLUX_TOKEN_FILE = os.getenv("INFLUX_TOKEN_FILE") or find_token_file() or ""


# ---- POINT SHAPE ----
MEASUREMENT = os.getenv("TELEM_MEASUREMENT", "telemetry")
TAG_SYSTEM = os.getenv("TELEM_SYSTEM", "dyno")
TAG_NODE = os.getenv("TELEM_NODE", "rp2040")

# Fields emitted by CarLoRaRxToPi (Bosch MS4.3 via LoRa)
DEFAULT_KEYS = ",".join([
    # Bosch ECU channels
    "rpm","veh_kph","tps_pct","ign_deg",
    "map_kpa","map_ext_kpa","lambda1","lambda2",
    "batt_v","coolant_f","oil_temp_f","air_f","gear",
    "fuel_psi","oil_psi","inj_ms",
    # IMU (LSM6DSOX) channels
    "ax_g","ay_g","az_g","gx_dps","gy_dps","gz_dps",
    # Link quality
    "rssi",
])
KEYS = [k.strip() for k in os.getenv("TELEM_KEYS", DEFAULT_KEYS).split(",") if k.strip()]


def load_token() -> str:
    """Load Influx token from env var or file."""
    if INFLUX_TOKEN:
        return INFLUX_TOKEN
    if INFLUX_TOKEN_FILE:
        with open(INFLUX_TOKEN_FILE, "r", encoding="utf-8") as f:
            return f.read().strip()
    raise SystemExit("Missing INFLUX_TOKEN or INFLUX_TOKEN_FILE")


def to_float(v: Any) -> Optional[float]:
    try:
        return float(v)
    except Exception:
        return None


def open_serial_forever() -> serial.Serial:
    """Open serial port, retrying forever."""
    while True:
        try:
            ser = serial.Serial(PORT, BAUD, timeout=None, exclusive=True)  # exclusive prevents two instances silently sharing the port and corrupting data
            try:
                ser.reset_input_buffer()
            except Exception:
                pass
            print(f"[serial] connected {PORT} @ {BAUD}")
            return ser
        except Exception as e:
            print(f"[serial] open failed: {e} (retrying)")
            time.sleep(1.0)


def make_point(obj: Dict[str, Any]) -> Optional[Point]:
    p = Point(MEASUREMENT).tag("system", TAG_SYSTEM).tag("node", TAG_NODE)

    pkt = obj.get("pkt")
    if pkt is not None:
        try:
            p = p.field("pkt", int(pkt))
        except Exception:
            # Keep going even if pkt isn't an int
            pass

    wrote_any = False
    for k in KEYS:
        v = to_float(obj.get(k))
        if v is None:
            continue
        p = p.field(k, v)
        wrote_any = True

    return p if wrote_any else None


def main() -> None:
    # Print configuration for debugging
    print("=" * 60)
    print("Dyno Telemetry Ingest Starting")
    print("=" * 60)
    print(f"InfluxDB URL:    {INFLUX_URL}")
    print(f"Organization:    {INFLUX_ORG}")
    print(f"Bucket:          {INFLUX_BUCKET}")
    print(f"Token file:      {INFLUX_TOKEN_FILE}")
    print(f"Serial port:     {PORT}")
    print(f"Baud rate:       {BAUD}")
    print("=" * 60)
    print()
    
    token = load_token()
    print(f"[influx] Token loaded ({len(token)} chars)")
    
    print(f"[influx] Connecting to {INFLUX_URL}...")
    influx = InfluxDBClient(url=INFLUX_URL, token=token, org=INFLUX_ORG)
    write_api = influx.write_api(write_options=SYNCHRONOUS)
    print("[influx] Connected successfully")
    print()

    ser = open_serial_forever()

    last_pkt_bosch = None
    last_pkt_imu   = None
    last_rate_t   = time.time()
    count         = 0
    lines_rx      = 0   # every line received from serial
    lines_deduped = 0   # skipped by dedup
    lines_nopoint = 0   # parsed ok but make_point returned None

    while True:
        t_read_start = time.time()
        try:
            raw = ser.read_until(b"\n")
        except Exception as e:
            print(f"[serial] read error: {e} (reopening)")
            try:
                ser.close()
            except Exception:
                pass
            time.sleep(0.5)
            ser = open_serial_forever()
            continue
        t_read_end = time.time()

        if not raw:
            continue

        line = raw.decode(errors="ignore").strip()
        if not line:
            continue
        if line.startswith("#") or line.startswith("DBG"):
            continue
        if not line.startswith("{"):
            print(f"[skip non-json] {line[:80]}")
            continue

        lines_rx += 1

        try:
            obj: Dict[str, Any] = json.loads(line)
        except json.JSONDecodeError:
            print(f"[bad json] {line[:120]}")
            continue

        pkt = obj.get("pkt")
        is_imu = obj.get("t") == "imu"
        tps    = obj.get("tps_pct")
        ts     = time.strftime("%H:%M:%S") + f".{int(time.time() * 1000) % 1000:03d}"

        if is_imu:
            if pkt is not None and pkt == last_pkt_imu:
                lines_deduped += 1
                continue
            last_pkt_imu = pkt
        else:
            if pkt is not None and pkt == last_pkt_bosch:
                lines_deduped += 1
                continue
            last_pkt_bosch = pkt
            # print every unique Bosch packet so we can see TPS in real time
            read_ms = (t_read_end - t_read_start) * 1000
            print(f"[rx] {ts}  pkt={pkt}  tps={tps}  rpm={obj.get('rpm')}  read={read_ms:.0f}ms")

        point = make_point(obj)
        if point is None:
            lines_nopoint += 1
            print(f"[no-point] keys in obj: {list(obj.keys())}")
            continue

        t_write_start = time.time()
        try:
            write_api.write(bucket=INFLUX_BUCKET, org=INFLUX_ORG, record=point)
            count += 1
        except Exception as e:
            print(f"[influx write error] {e}")
        t_write_end = time.time()

        write_ms = (t_write_end - t_write_start) * 1000
        if write_ms > 50:
            print(f"[SLOW WRITE] {write_ms:.0f}ms  pkt={pkt}  tps={tps}")

        # health print every 5s
        now = time.time()
        if now - last_rate_t >= 5.0:
            elapsed = now - last_rate_t
            rate = count / elapsed
            read_ms = (t_read_end - t_read_start) * 1000
            print(
                f"[ingest] {rate:.1f} pts/sec written | "
                f"rx={lines_rx} deduped={lines_deduped} nopoint={lines_nopoint} | "
                f"last serial read={read_ms:.0f}ms last write={write_ms:.0f}ms | "
                f"tps={obj.get('tps_pct')} rpm={obj.get('rpm')}"
            )
            count = 0
            lines_rx = 0
            lines_deduped = 0
            lines_nopoint = 0
            last_rate_t = now


if __name__ == "__main__":
    main()
