JacksonHarvey1/FSAE2025/Testing/TransmitterTest/TransmitterTest.ino

#include <Arduino.h>
#include <SPI.h>
#include <RH_RF95.h>

#define RFM95_CS   16
#define RFM95_RST  17
#define RFM95_INT  21
#define RF95_FREQ  915.0

// If a CAN wing / other SPI device is stacked:
#define CAN_CS     5

RH_RF95 rf95(RFM95_CS, RFM95_INT);

uint32_t counter = 0;

// LED blink timing (TX: 1.0s)
const uint32_t BLINK_MS = 1000;
uint32_t lastBlink = 0;
bool ledState = false;

void setup() {
  pinMode(LED_BUILTIN, OUTPUT);
  digitalWrite(LED_BUILTIN, LOW);

  Serial.begin(115200);
  Serial.println("\n--- LoRa TX starting ---");

  pinMode(CAN_CS, OUTPUT);
  digitalWrite(CAN_CS, HIGH);

  // Force SPI pins to Feather defaults (MISO=8, MOSI=15, SCK=14)
  SPI.setRX(8);
  SPI.setTX(15);
  SPI.setSCK(14);
  SPI.begin();

  // Reset radio
  pinMode(RFM95_RST, OUTPUT);
  digitalWrite(RFM95_RST, HIGH);
  delay(10);
  digitalWrite(RFM95_RST, LOW);  delay(10);
  digitalWrite(RFM95_RST, HIGH); delay(10);

  if (!rf95.init()) {
    Serial.println("ERROR: LoRa radio init FAILED");
    while (1) delay(100);
  }

  if (!rf95.setFrequency(RF95_FREQ)) {
    Serial.println("ERROR: setFrequency FAILED");
    while (1) delay(100);
  }

  rf95.setTxPower(13, false);
  Serial.println("LoRa init OK");
}

void loop() {
  uint32_t now = millis();

  // Blink LED every 1 second
  if (now - lastBlink >= BLINK_MS) {
    lastBlink = now;  
    ledState = !ledState;
    digitalWrite(LED_BUILTIN, ledState);
  }

  // Send message every 1 second (tied to same cadence as blink)
  static uint32_t lastSend = 0;
  if (now - lastSend >= 1000) {
    lastSend = now;

    char msg[64];
    snprintf(msg, sizeof(msg), "hello from TX! count=%lu", (unsigned long)counter++);

    Serial.print("[TX] Sending: ");
    Serial.println(msg);

    rf95.send((uint8_t*)msg, strlen(msg));
    rf95.waitPacketSent();
  }
}
