JacksonHarvey1/FSAE2025/(commit log)

2025-10-12 Update Visibility
    [data2024-03-17 02_47_35.926.csv, data2024-03-17 02_48_59.901.csv]
2025-10-20 Data 10/19/2025
    [10_18_run1_001.csv, 10_18_run1_001_analysis.xlsx, 10_18_run2_001.csv, 10_18_run2_001_analysis.xlsx, 10_18_run3_001.csv, 10_18_run3_001_analysis.xlsx, 10_18_run4_001.csv, 10_18_run4_001.xlsx]
2025-10-23 process trevisios
    [10_18_run1_001_analysis.xlsx, 10_18_run2_001_analysis.xlsx, 10_18_run3_001_analysis.xlsx, 10_18_run4_001_analysis.xlsx, 10_18_run5_001_analysis.xlsx, 10_18_run6_001_analysis.xlsx, idle_001_analysis.xlsx]
2025-11-04 Old RaspverryPi code from 2025 car
    [pyvenv.cfg]
2025-11-05 updates for combined graphs
    [10_18_run1_001_analysis.xlsx, 10_18_run2_001_analysis.xlsx, 10_18_run3_001_analysis.xlsx, 10_18_run4_001_analysis.xlsx, 10_18_run5_001_analysis.xlsx, 10_18_run6_001_analysis.xlsx, Zach1_001 (1)_analysis.xlsx, idle_001_analysis.xlsx]
2025-12-23 reorganization and updated tansmission files
    [data2024-03-17 02_47_35.926.csv, data2024-03-17 02_48_59.901.csv, pyvenv.cfg]
2025-12-28 integratede board changes
    [project.cfg]
2025-12-28 Udpates for corruption issues
    [DynoRP204CANHATINtegration.ino, RP2040comm.py, dyno_simple.py, live_can_plot.py]
2026-02-10 Accelerometer tests
2026-03-18 Data stuff
    [10_18_run1_001.csv, 10_18_run1_001_analysis.xlsx, 10_18_run2_001.csv, 10_18_run2_001_analysis.xlsx, 10_18_run3_001.csv, 10_18_run3_001_analysis.xlsx, 10_18_run4_001.csv, 10_18_run4_001.xlsx]
2026-03-19 Data update 3192026
    [3-19-26 Dyno Test Run 1_001.csv, 3-19-26 Dyno Test Run 2_001.csv]
2026-03-21 Board updates and Duno data
    [3-21-26 Dyno Test Run 1_001.csv]
2026-03-28 3282025 data
    [3-27-26 Dyno Test Run 1_001.csv, 3-28-26 Dyno Test Run 1_001.csv, 3-28-26 Dyno Test Run 2 (Multiple tries)_001.csv, 3-28-26 Dyno Test Run 3 (2 full runs)_001.csv]
2026-03-31 Data and Gear iNdicator working
    [3-30-26 Dyno Test Run 1_001.csv, 3-30-26 Dyno Test Run 2_001.csv, 3-30-26 Dyno Test Run 3_001.csv, 3-30-26 Dyno Test Run 4_001.csv, 3-30-26 Dyno Test Run 5_001.csv, 3-30-26 Dyno Test Run 6_001.csv, 3-30-26 Dyno Test Run 6_001.xlsx, 3-30-26 Neutral Drive Revs Oaks Intake_001.csv]
2026-03-31 MicroSD working and LED working
2026-04-13 Updated car and data
    [4-13-26 Dyno Test Run 1_001.csv]
2026-04-14 Data nd finals
    [4-13-26 Dyno Test Run 2_001.csv, 4-13-26 Dyno Test Run 3_001.csv, 4-13-26 Dyno Test Run 4_001.csv, 4-13-26 Dyno Test Run 5_001.csv, 4-13-26 Dyno Test Run 6_001.csv, 4-13-26 Dyno Test Run 6_002.csv, 4-13-26 Dyno Test Run 7_001.csv, 4-13-26 Dyno Test Run 8_001.csv]
